reparator/The-BallClock/README.md

# The-BallClock
A minimalistic Clock

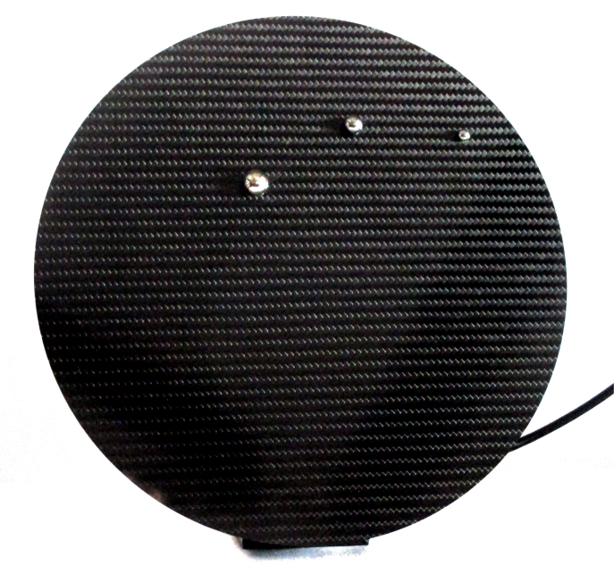
[picture p1: Ballclock.png]
Ballclock


If you want to build one or if you are interested in the project, here you can find the parts and instructions:

https://www.thingiverse.com/thing:5811567

https://www.instructables.com/The-BallClock
