reparator/The-BallClock/Elektronik/README.txt

The BallClock:
Here you find all files related to the electronics hardware: 
Schematics, board, BOM, layouts, assembly diagrams
