reparator/The-BallClock/Elektronik/PI_E1467461.pdf

E1467461 PCB view TOP (topview)

E1467461 TOP layer Image (topview)

E1467461 BOTTOM layer Image (topview)

E1467461 PCB view BOTTOM (bottomview)

# E1467461 PCB Mechanical view (topview)

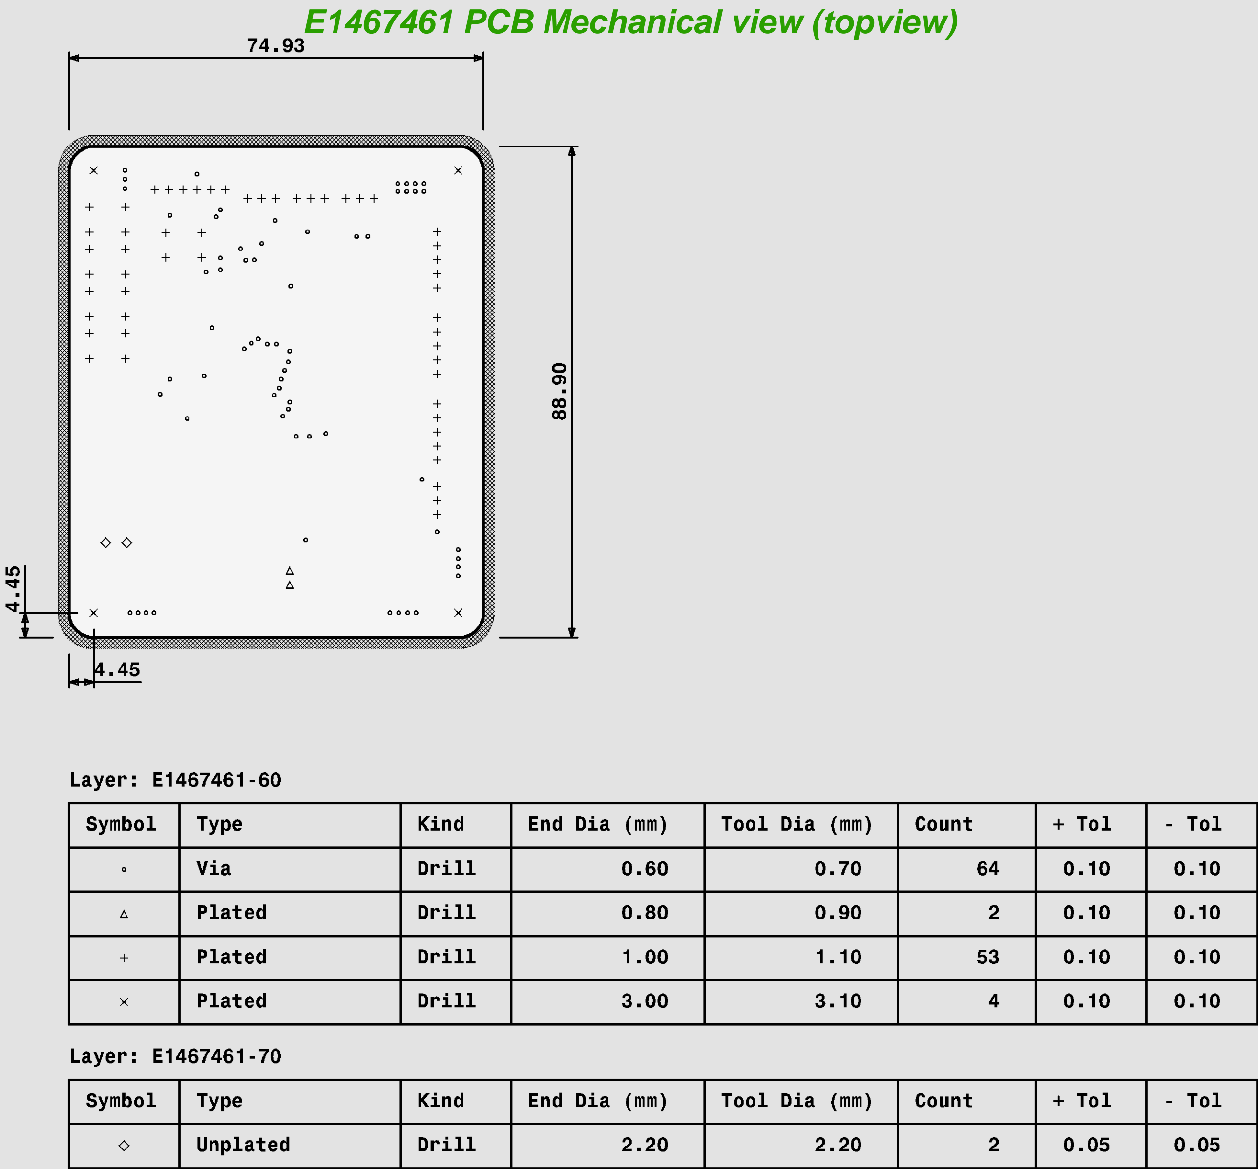
[picture p2: page 5]
