reparator/The-BallClock/Elektronik/28BYJ-48-Connection.png

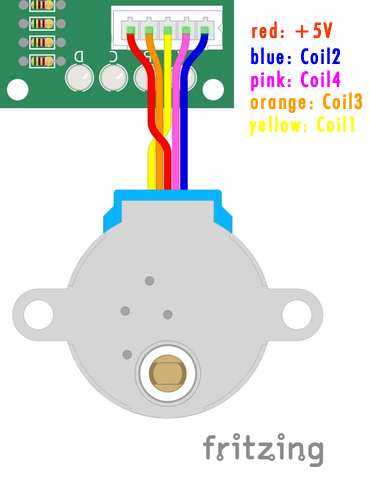
Elektronik/28BYJ-48-Connection.png
