reparator/The-BallClock/Elektronik/A3144.png

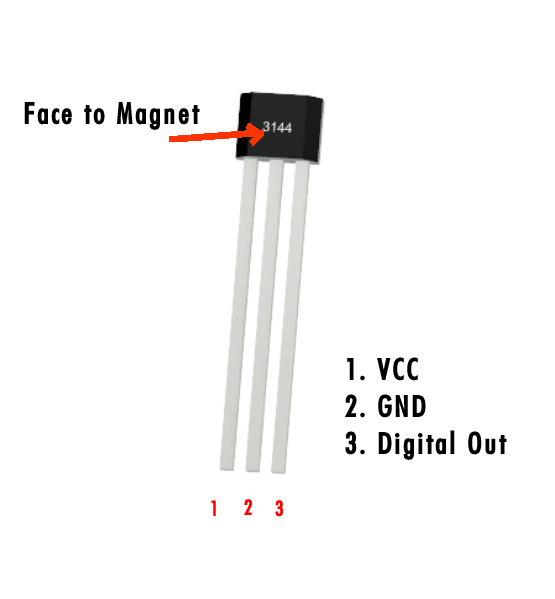
Elektronik/A3144.png
