reparator/The-BallClock/Elektronik/TheBallClockSchematic.pdf

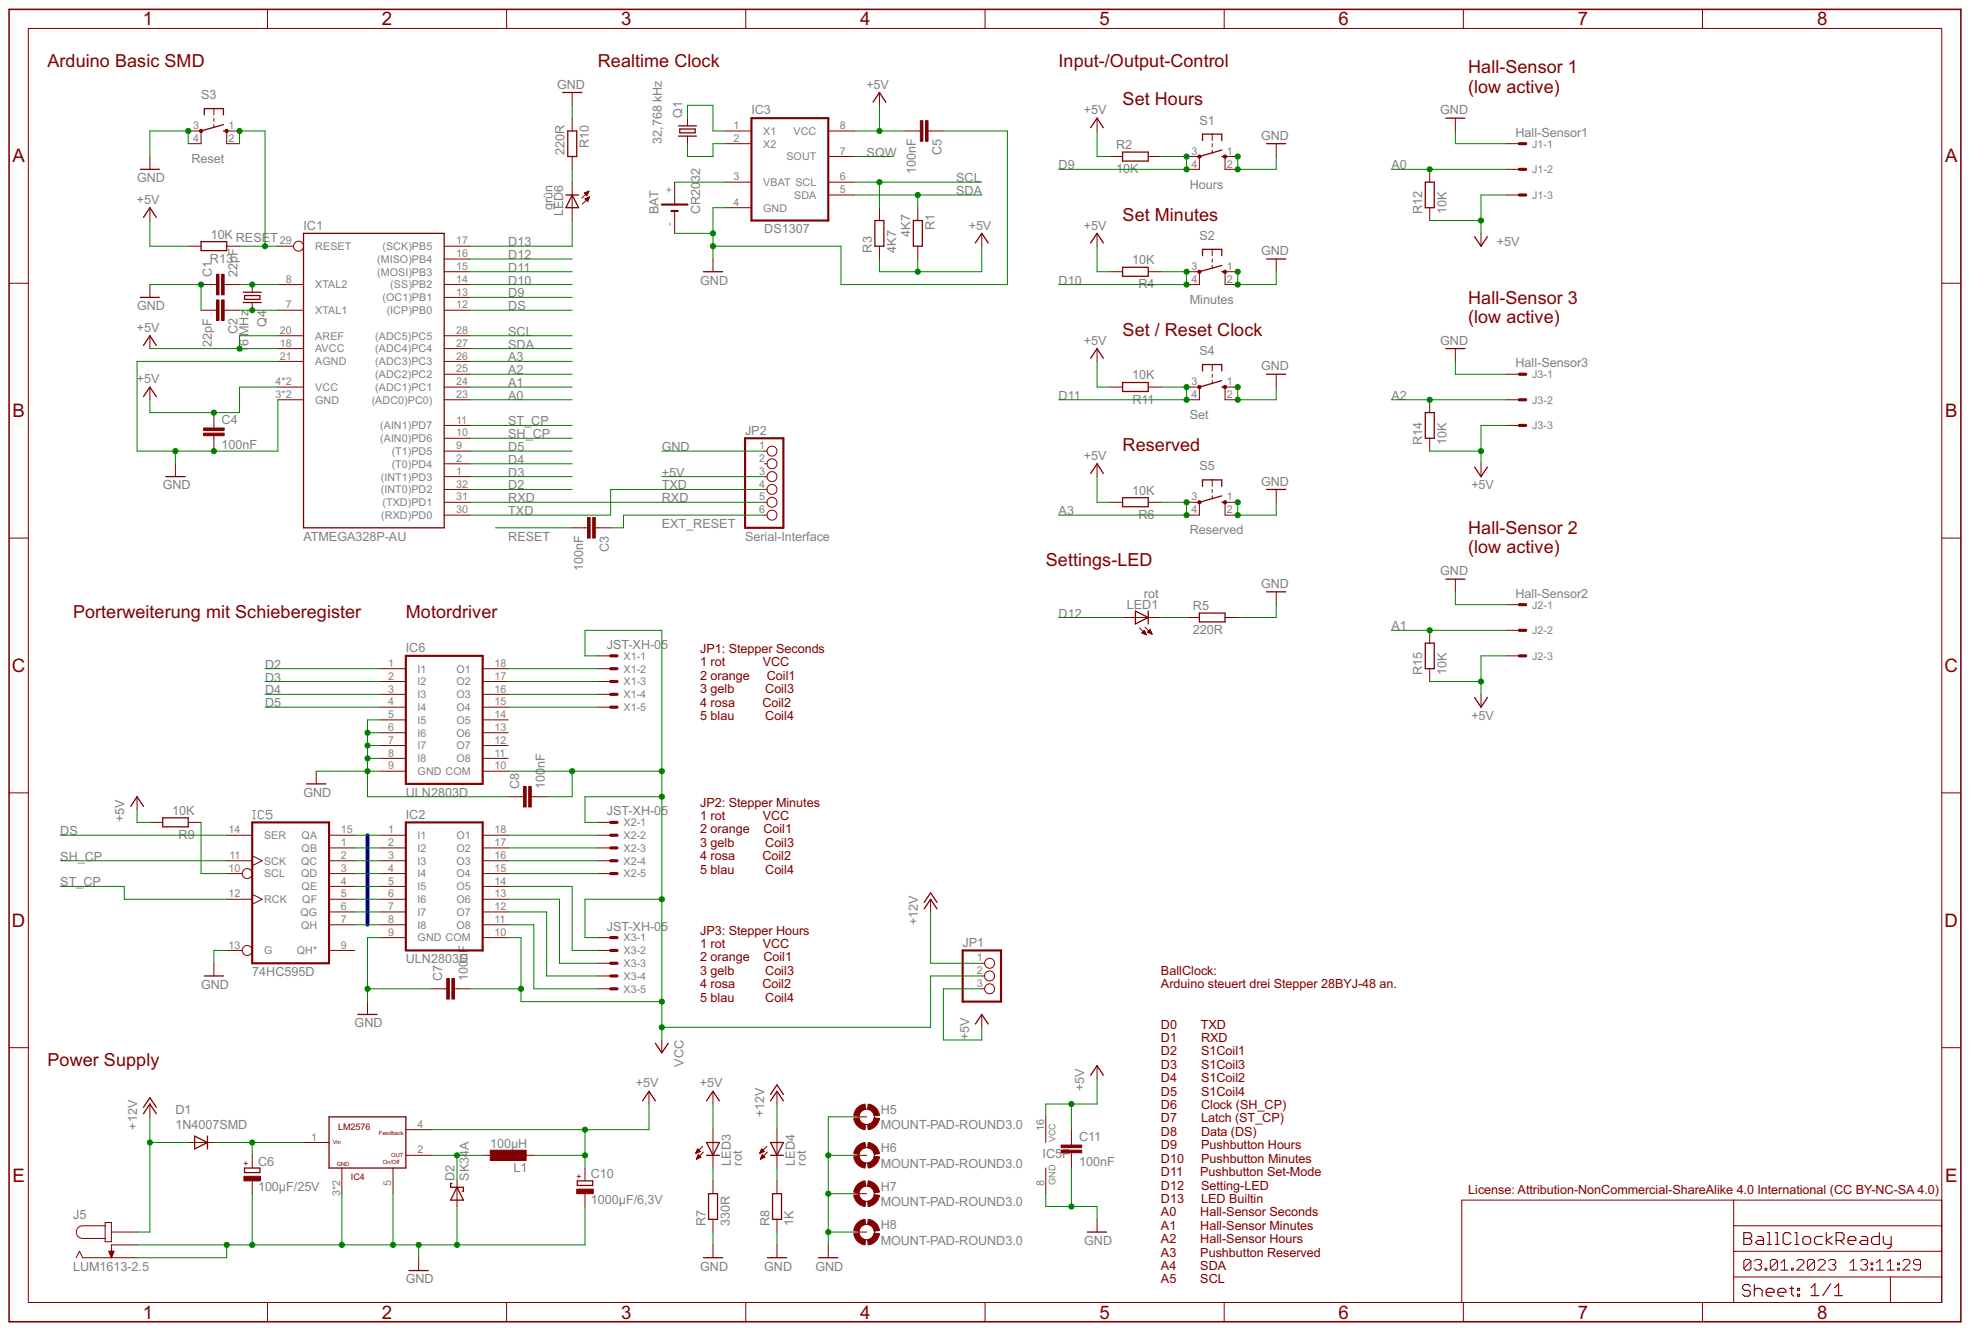
[picture p10: page 1]

Set Hours Set Minutes Set / Reset Clock

MOUNT-PAD-ROUND3.0 MOUNT-PAD-ROUND3.0

License: Attribution-NonCommercial-ShareAlike 4.0 International (CC BY-NC-SA 4.0)
