reparator/The-BallClock/Elektronik/TheBallClock-PartsBS.pdf

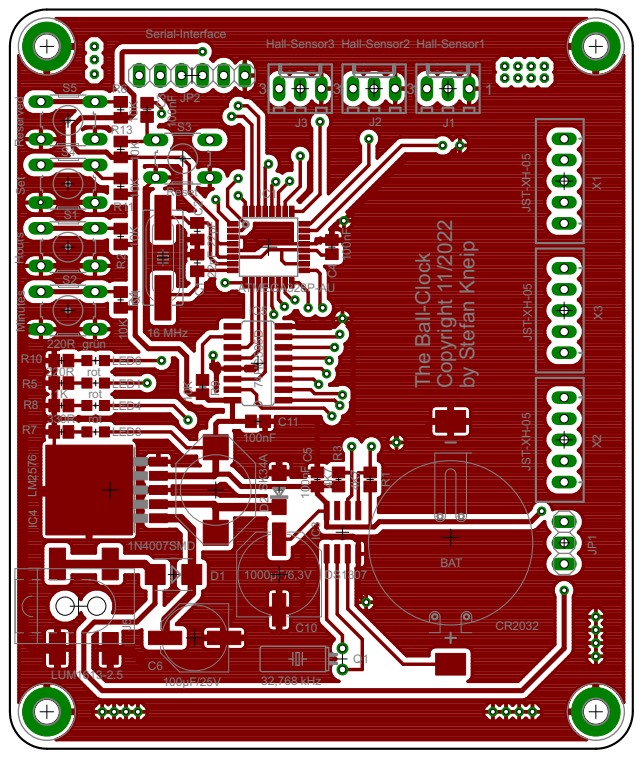
[picture p11: page 1]
