reparator/The-BallClock/Elektronik/TheBallClock-PartsLS.pdf

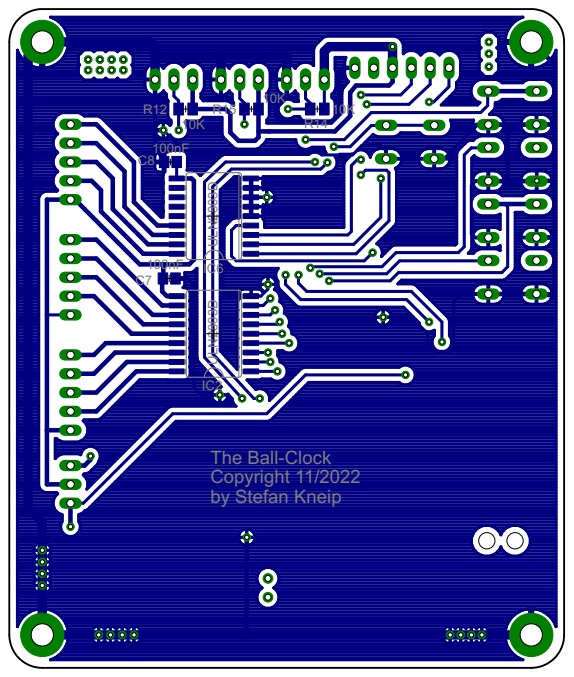
[picture p12: page 1]
