reparator/The-BallClock/Elektronik/TheBallClock-BS.pdf

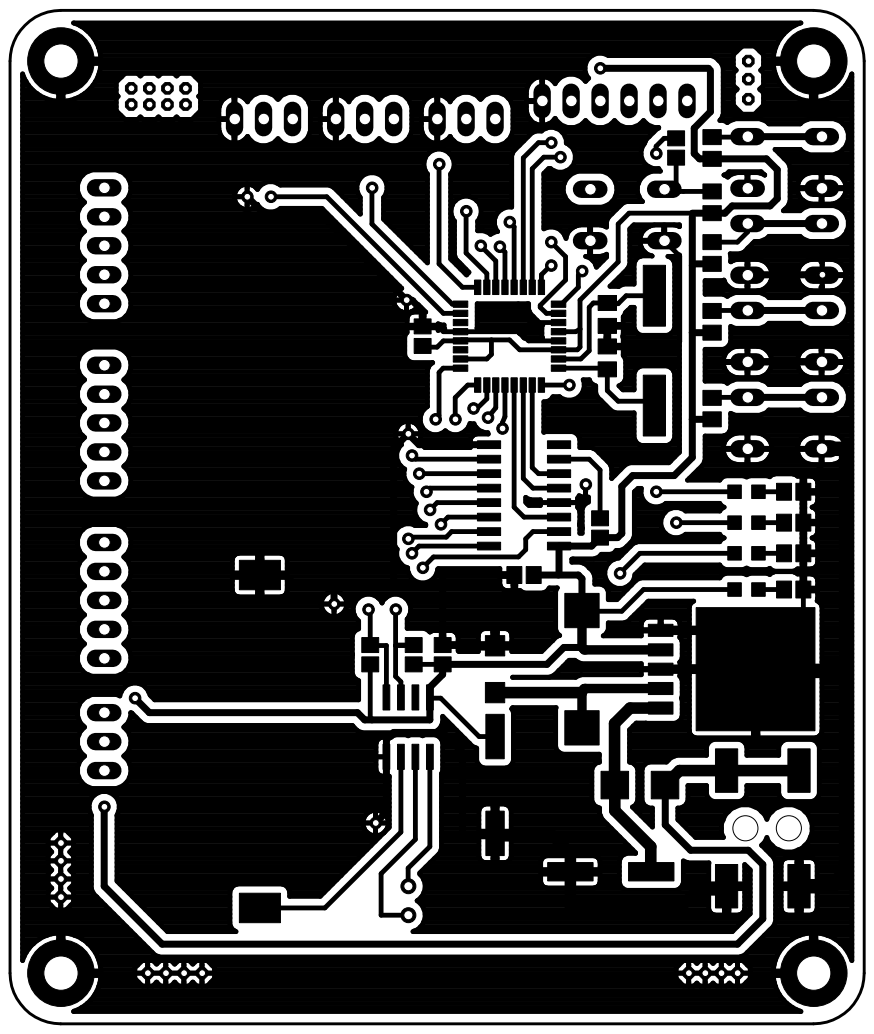
[picture p13: page 1]
