reparator/The-BallClock/Elektronik/TheBallClock-LS.pdf

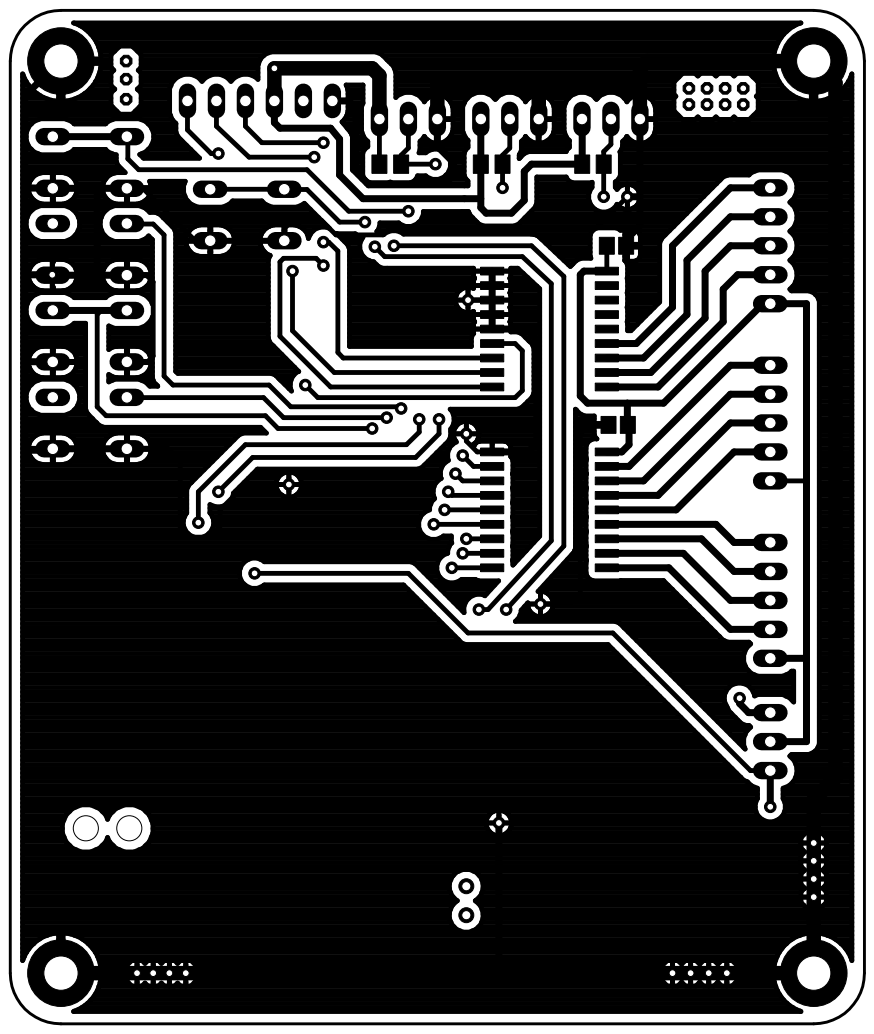
[picture p14: page 1]
