reparator/The-BallClock/Elektronik/TheBallClock.brd

## EAGLE design Elektronik/TheBallClock.brd (2023-01-26)

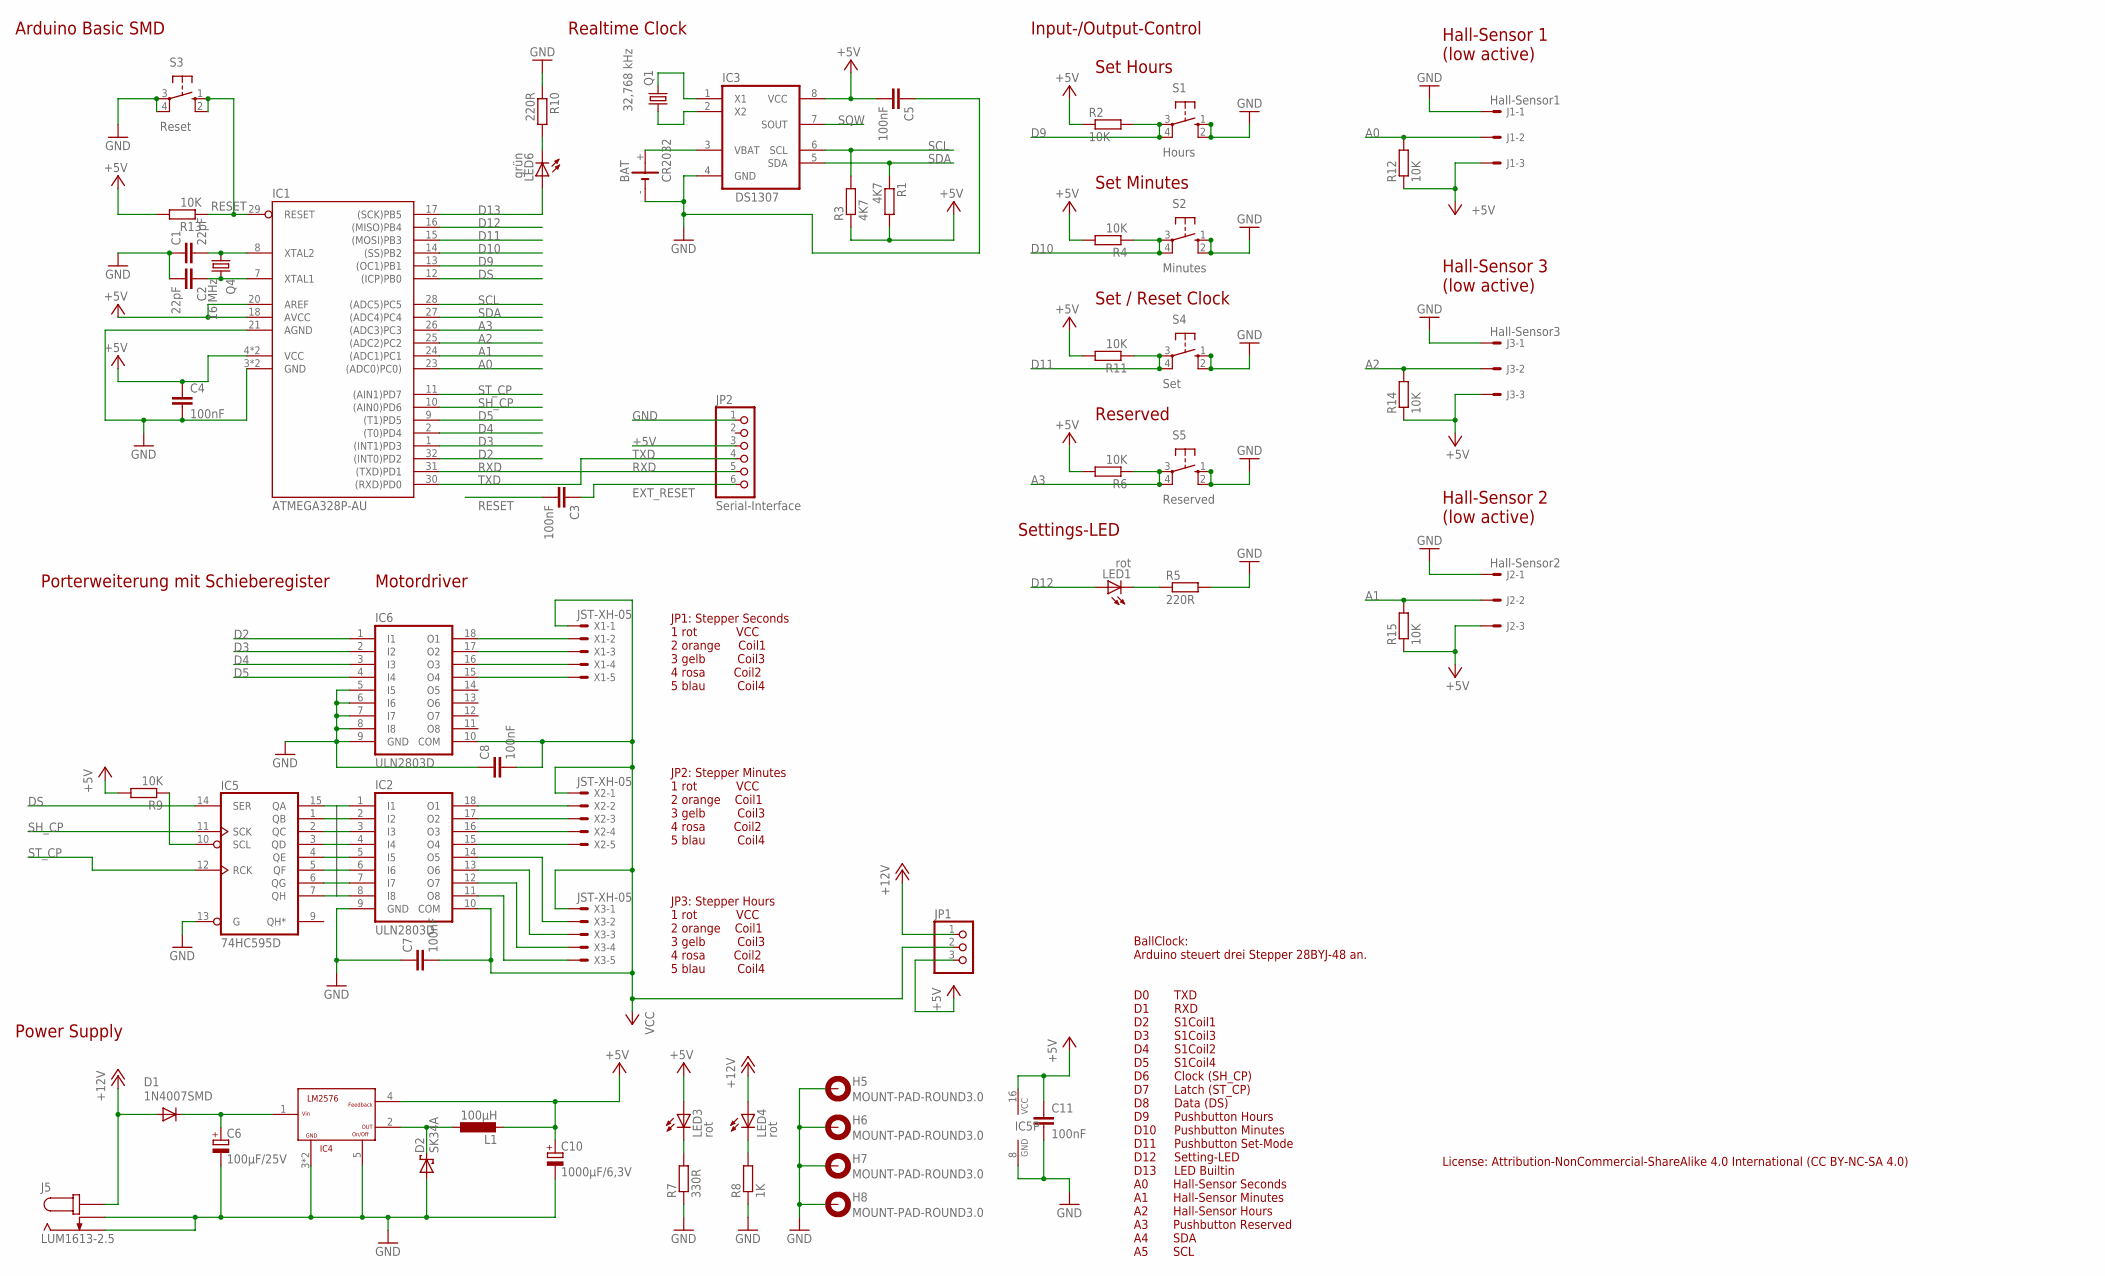
[picture p15: schematic TheBallClock.sch]

Parts:
BAT: CR2032; KZH20-SMD
C1, C2: 22pF; C0805K
C3, C4, C5, C7, C8, C11: 100nF; C0805
C6: 100µF/25V; PANASONIC_F
C10: 1000µF/6,3V; PANASONIC_G
D1: 1N4007SMD; SMB
D2: SK34A; DO214AC
H5, H6, H7, H8: MOUNT-PAD-ROUND3.0; 3,0-PAD
IC1: ATMEGA328P-AU; TQFP32-08
IC2, IC6: ULN2803D; SO18W
IC3: DS1307; SO08
IC4: LM2576; TO263-5
IC5: 74HC595D; SO16
J1: Hall-Sensor1; 6410-03
J2: Hall-Sensor2; 6410-03
J3: Hall-Sensor3; 6410-03
J5: LUM1613-2.5; LUM_DS_1613_15
JP1: PINHD-1X3; 1X03
JP2: Serial-Interface; 1X06
L1: 100µH; PISM
LED1, LED3, LED4: rot; CHIPLED_0805
LED6: grün; CHIPLED_0805
Q1: 32,768 kHz; TC38H
Q4: 16 MHz; HC49UP
R1, R3: 4K7; R0805
R2, R4, R6, R11, R12, R13, R14, R15: 10K; M0805
R5, R10: 220R; R0805
R7: 330R; R0805
R8: 1K; R0805
R9: 10K; R0805
S1: Hours; B3F-10XX
S2: Minutes; B3F-10XX
S3: Reset; B3F-10XX
S4: Set; B3F-10XX
S5: Reserved; B3F-10XX
X1, X2, X3: JST-XH-05; JST-XH-05-PACKAGE-LONG-PAD

Connections:
+5V: C4.1, C5.2, C10.+, C11.1, IC1.4 (VCC), IC1.6 (VCC), IC1.18 (AVCC), IC1.20 (AREF), IC3.8 (VCC), IC4.4 (FEEDBACK), IC5.16 (VCC), J1.3, J2.3, J3.3, JP1.3, JP2.3, L1.2, LED3.A, R1.2, R2.1, R3.1, R4.2, R6.2, R9.2, R11.2, R12.1, R13.2, R14.1, R15.1
+12V: D1.A, J5.3A (1), J5.3B (1), JP1.1, LED4.A
A0: IC1.23 ((ADC0)PC0)), J1.2, R12.2
A1: IC1.24 ((ADC1)PC1), J2.2, R15.2
A2: IC1.25 ((ADC2)PC2), J3.2, R14.2
A3: IC1.26 ((ADC3)PC3), R6.1, S5.3, S5.4 (P1)
BUS1: IC2.1 (I1), IC5.15 (QA)
BUS2: IC2.2 (I2), IC5.1 (QB)
BUS3: IC2.3 (I3), IC5.2 (QC)
BUS4: IC2.4 (I4), IC5.3 (QD)
BUS5: IC2.5 (I5), IC5.4 (QE)
BUS6: IC2.6 (I6), IC5.5 (QF)
BUS7: IC2.7 (I7), IC5.6 (QG)
BUS8: IC2.8 (I8), IC5.7 (QH)
D2: IC1.32 ((INT0)PD2), IC6.1 (I1)
D3: IC1.1 ((INT1)PD3), IC6.2 (I2)
D4: IC1.2 ((T0)PD4), IC6.3 (I3)
D5: IC1.9 ((T1)PD5), IC6.4 (I4)
D9: IC1.13 ((OC1)PB1), R2.2, S1.3, S1.4 (P1)
D10: IC1.14 ((SS)PB2), R4.1, S2.3, S2.4 (P1)
D11: IC1.15 ((MOSI)PB3), R11.1, S4.3, S4.4 (P1)
D12: IC1.16 ((MISO)PB4), LED1.A
D13: IC1.17 ((SCK)PB5), LED6.A
DS: IC1.12 ((ICP)PB0), IC5.14 (SER)
EXT_RESET: C3.1, JP2.6
GND: BAT.-, C1.1, C2.2, C4.2, C5.1, C6.-, C7.1, C8.1, C10.-, C11.2, D2.A, H5.B3,0, H6.B3,0, H7.B3,0, H8.B3,0, IC1.3 (GND), IC1.5 (GND), IC1.21 (AGND), IC2.9 (GND), IC3.4 (GND), IC4.3 (GND), IC4.5 (ON/OFF), IC4.6 (GND), IC5.8 (GND), IC5.13 (G), IC6.5 (I5), IC6.6 (I6), IC6.7 (I7), IC6.8 (I8), IC6.9 (GND), J1.1, J2.1, J3.1, J5.1 (2), J5.2 (3), JP2.1, R5.2, R7.1, R8.1, R10.1, S1.1 (S), S1.2 (S1), S2.1 (S), S2.2 (S1), S3.3, S3.4 (P1), S4.1 (S), S4.2 (S1), S5.1 (S), S5.2 (S1)
unnamed: LED1.C, R5.1
unnamed: BAT.+, IC3.3 (VBAT)
unnamed: D2.C, IC4.2 (OUTPUT), L1.1
unnamed: LED3.C, R7.2
unnamed: LED4.C, R8.2
unnamed: C6.+, D1.C, IC4.1 (+VIN)
unnamed: C1.2, IC1.8 (XTAL2), Q4.1
unnamed: IC2.18 (O1), X2.2
unnamed: C2.1, IC1.7 (XTAL1), Q4.2
unnamed: LED6.C, R10.2
unnamed: IC2.17 (O2), X2.3
unnamed: IC2.16 (O3), X2.4
unnamed: IC2.15 (O4), X2.5
unnamed: IC2.14 (O5), X3.2
unnamed: IC2.13 (O6), X3.3
unnamed: IC2.12 (O7), X3.4
unnamed: IC2.11 (O8), X3.5
unnamed: IC6.18 (O1), X1.2
unnamed: IC6.17 (O2), X1.3
unnamed: IC6.16 (O3), X1.4
unnamed: IC6.15 (O4), X1.5
unnamed: IC5.10 (SCL), R9.1
unnamed: IC3.1 (X1), Q1.2
unnamed: IC3.2 (X2), Q1.1
RESET: C3.2, IC1.29 (RESET), R13.1, S3.1 (S), S3.2 (S1)
RXD: IC1.31 ((TXD)PD1), JP2.5
SCL: IC1.28 ((ADC5)PC5), IC3.6 (SCL), R3.2
SDA: IC1.27 ((ADC4)PC4), IC3.5 (SDA), R1.1
SH_CP: IC1.10 ((AIN0)PD6), IC5.11 (SCK)
SQW: IC3.7 (SOUT)
ST_CP: IC1.11 ((AIN1)PD7), IC5.12 (RCK)
TXD: IC1.30 ((RXD)PD0), JP2.4
VCC: C7.2, C8.2, IC2.10 (COM), IC6.10 (COM), JP1.2, X1.1, X2.1, X3.1

Notes on the sheet:
Arduino Basic SMD
Realtime Clock
Input-/Output-Control
Power Supply
Hall-Sensor 1 (low active)
Hall-Sensor 3 (low active)
JP1: Stepper Seconds 1 rot VCC 2 orange Coil1 3 gelb Coil3 4 rosa Coil2 5 blau Coil4
JP2: Stepper Minutes 1 rot VCC 2 orange Coil1 3 gelb Coil3 4 rosa Coil2 5 blau Coil4
BallClock: Arduino steuert drei Stepper 28BYJ-48 an. D0 TXD D1 RXD D2 S1Coil1 D3 S1Coil3 D4 S1Coil2 D5 S1Coil4 D6 Clock (SH_CP) D7 Latch (ST_CP) D8 Data (DS) D9 Pushbutton Hours D10 Pushbutton Minutes D11 Pushbutton Set-Mode D12 Setting-LED D13 LED Builtin A0 Hall-Sensor Seconds A1 Hall-Sensor Minu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
Porterweiterung mit Schieberegister
Motordriver
Hall-Sensor 2 (low active)
JP3: Stepper Hours 1 rot VCC 2 orange Coil1 3 gelb Coil3 4 rosa Coil2 5 blau Coil4
Set Hours
Set Minutes
Set / Reset Clock
Settings-LED
Reserved
License: Attribution-NonCommercial-ShareAlike 4.0 International (CC BY-NC-SA 4.0)

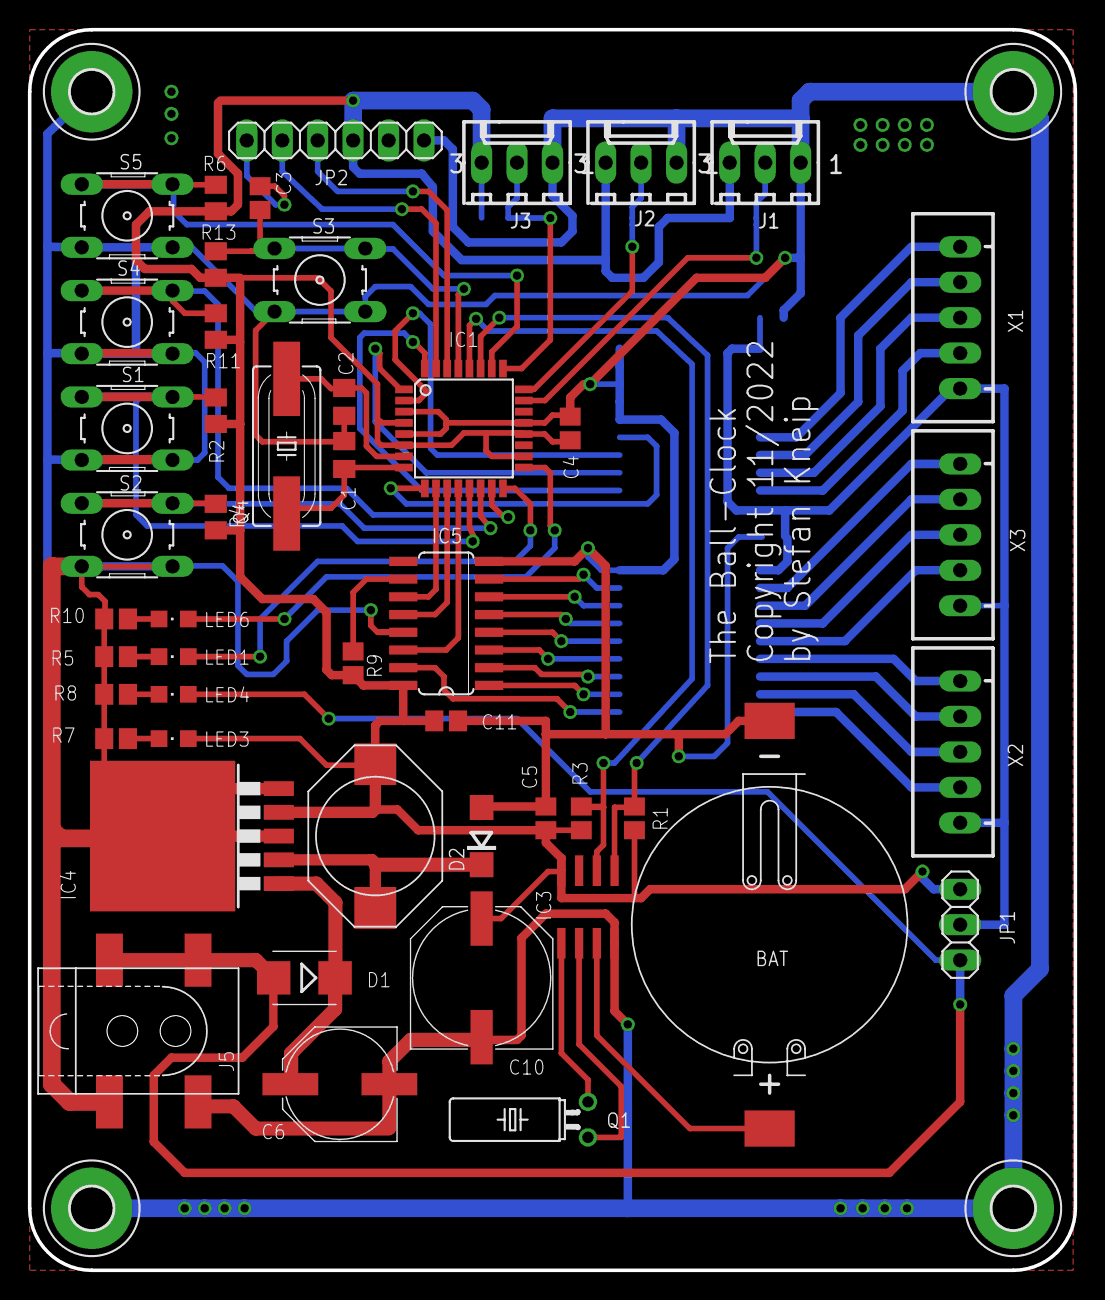
[picture p16: board TheBallClock.brd from above]

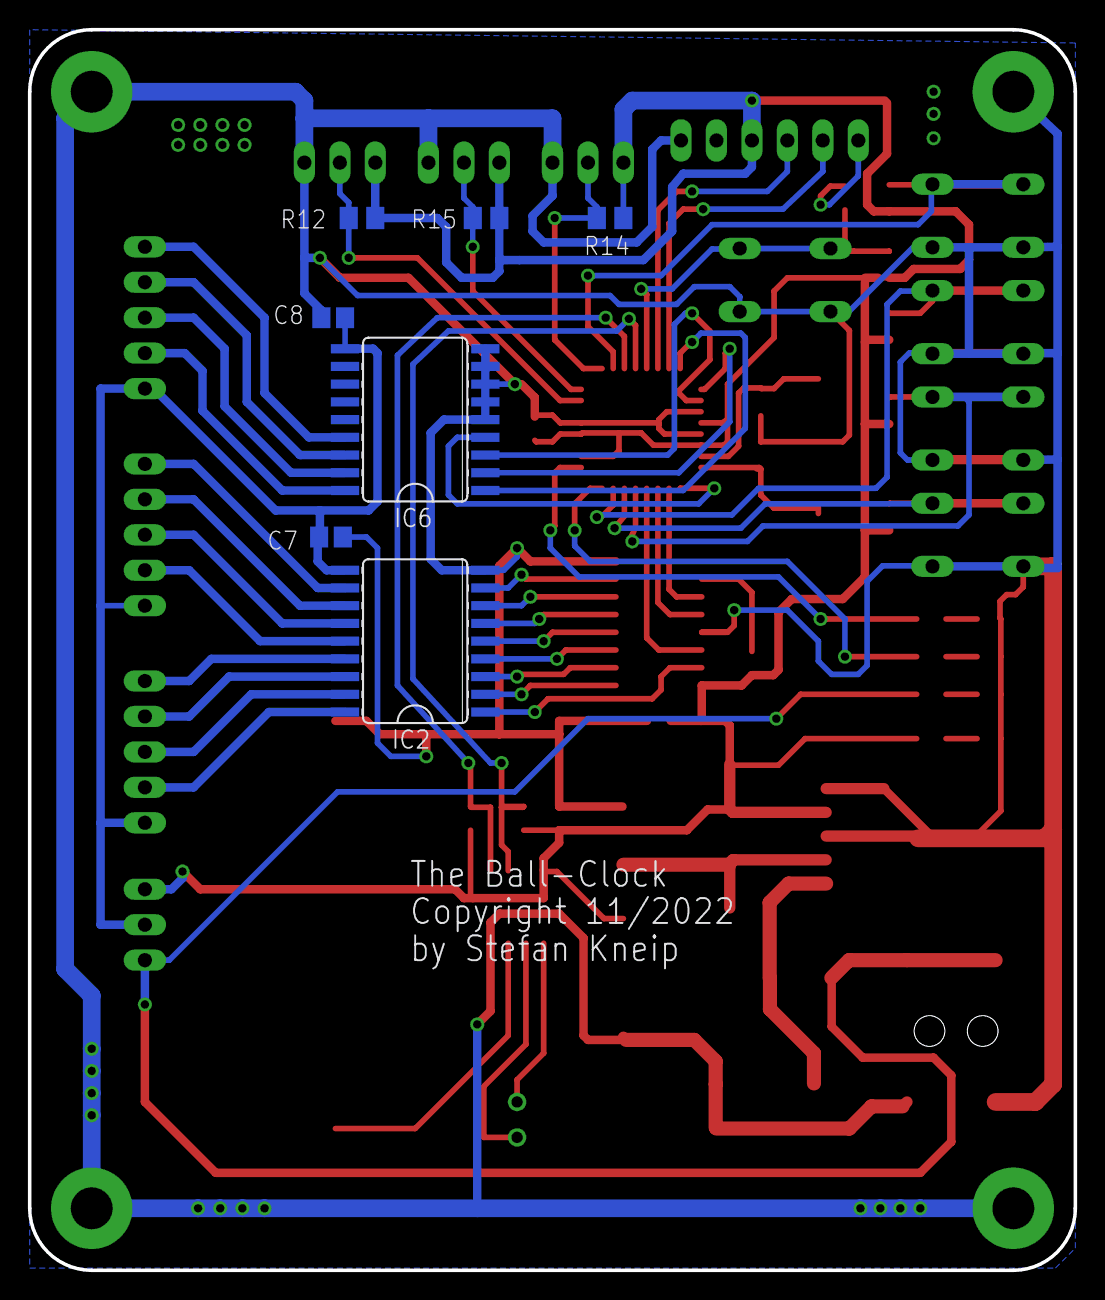
[picture p17: board TheBallClock.brd from below]

Board: 2 copper layers, 74.9 x 88.9 mm, 59 parts (7 on the bottom side), 58 nets.
