reparator/The-BallClock/(notices)

Notices in the files:
parts and their libraries:
MyEagle: CC Copyright by Stefan Kneip
